fractalxaos/radmon/docs/MightyOhmSchematic.jpg

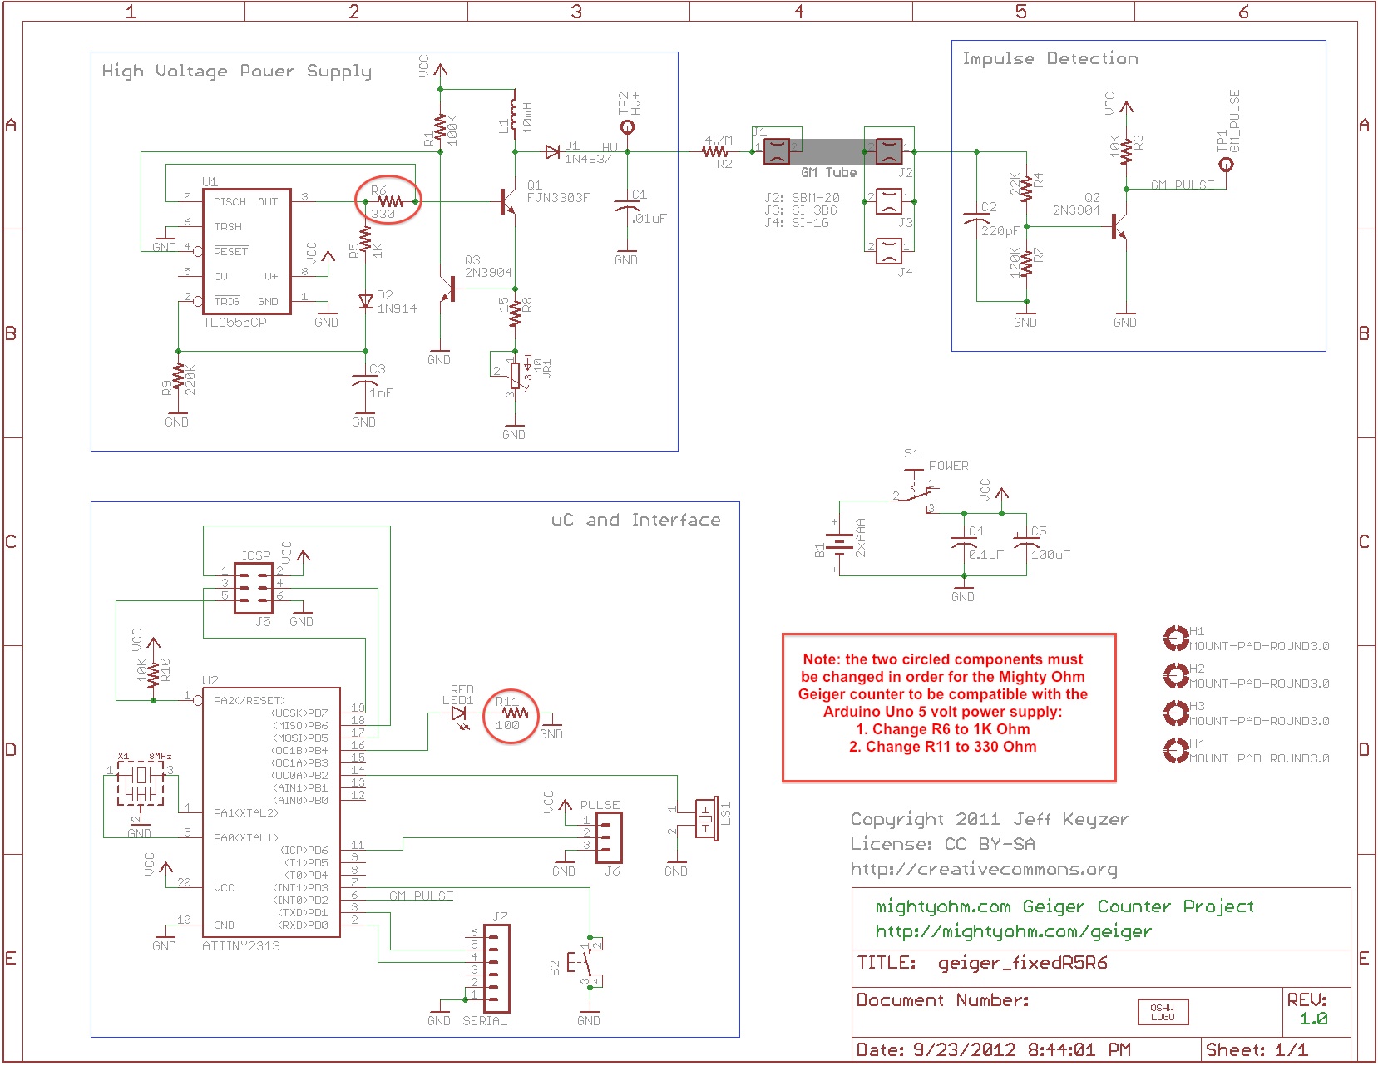
docs/MightyOhmSchematic.jpg
