fractalxaos/radmon/(commit log)

2019-12-02 fixed bug in NTP clock synchronization
    [Radmon.ino]
2022-07-07 added MightyOhm assembly instructions
